zoltan-234/ROBI-esp32/docs/ROBI_Beuzemelesi_utmutato_szoftver.pdf

R.O.B.I.

## Radar · Óra · Barát · Időjárás

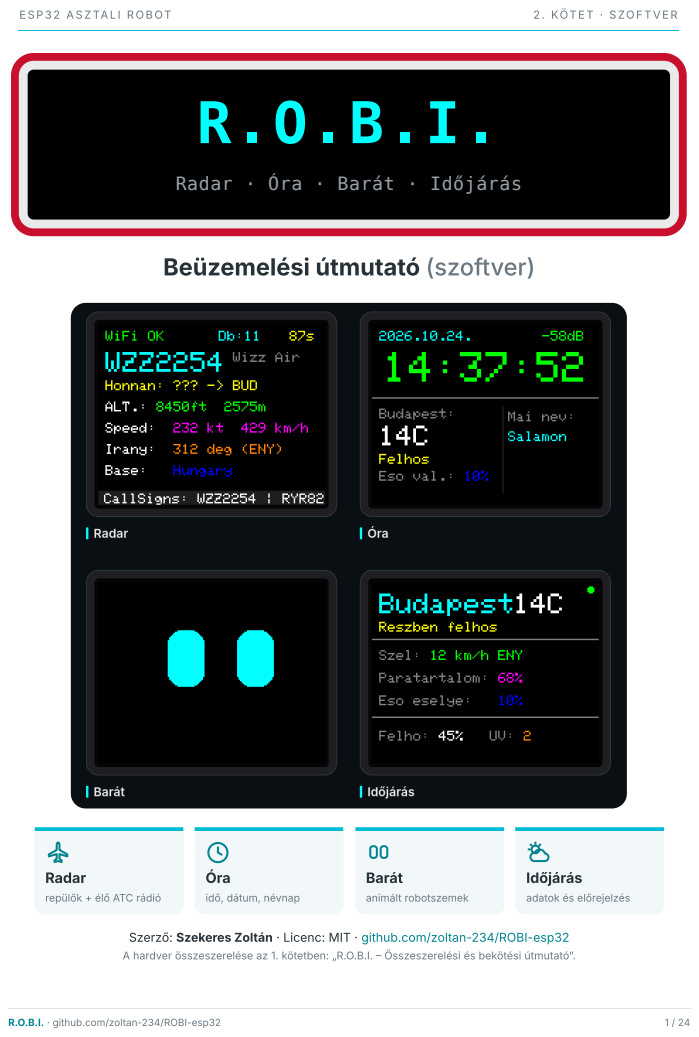
[picture p22: page 1]
ESP32 ASZTALI ROBOT; 2. KÖTET · SZOFTVER; Óra; Barát; animált robotszemek; A hardver összeszerelése az 1. kötetben: „R.O.B.I. –; Összeszerelési és bekötési útmutató”.; R.O.B.I. · github.com/zoltan-234/ROBI-esp32

Beüzemelési útmutató (szoftver)

Radar
repülők + élő ATC rádió

Időjárás
adatok és előrejelzés

idő, dátum, névnap

Szerző: Szekeres Zoltán · Licenc: MIT · github.com/zoltan-234/ROBI-esp32

R.O.B.I. · Beüzemelési útmutató (szoftver)

Kattints egy fejezetcímre, és a PDF odaugrik.

1 | Hogyan működik ROBI? | 3
2 | Letöltések – mit, honnan | 4
3 | Arduino IDE beállítása | 5
3.4 | Könyvtárak – pontos verziók | 6
4 | A projekt fájljai – mi hol van | 7
4.1 | secrets.h – kötelező | 7
4.2 | config.h – fő beállítások | 8
4.3 | ATC rádiócsatornák cseréje vagy bővítése | 9
4.4 | A repülőradar figyelt területe | 10
4.5 | Az időjárás helyszínének módosítása | 11
4.6 | Haladó beállítások | 12
5 | Gombok és módok – programonként | 13
5.1 | Repülőradar | 14
5.2 | Óra | 15
5.3 | Időjárás | 16
5.4 | Barát (MiniFace) | 17
5.4 | ROBI napirendje, éhség | 18
5.4 | ROBI arcai | 19
5.5 | „Nincs WiFi” képernyő | 20
6 | Alaplap-beállítások (Tools menü) | 21
7 | Feltöltés és első indítás | 22
8 | Gyakori hibák | 23
9 | Hasznos tudnivalók | 24

# Tartalom

R.O.B.I.

# 1 Hogyan működik ROBI?

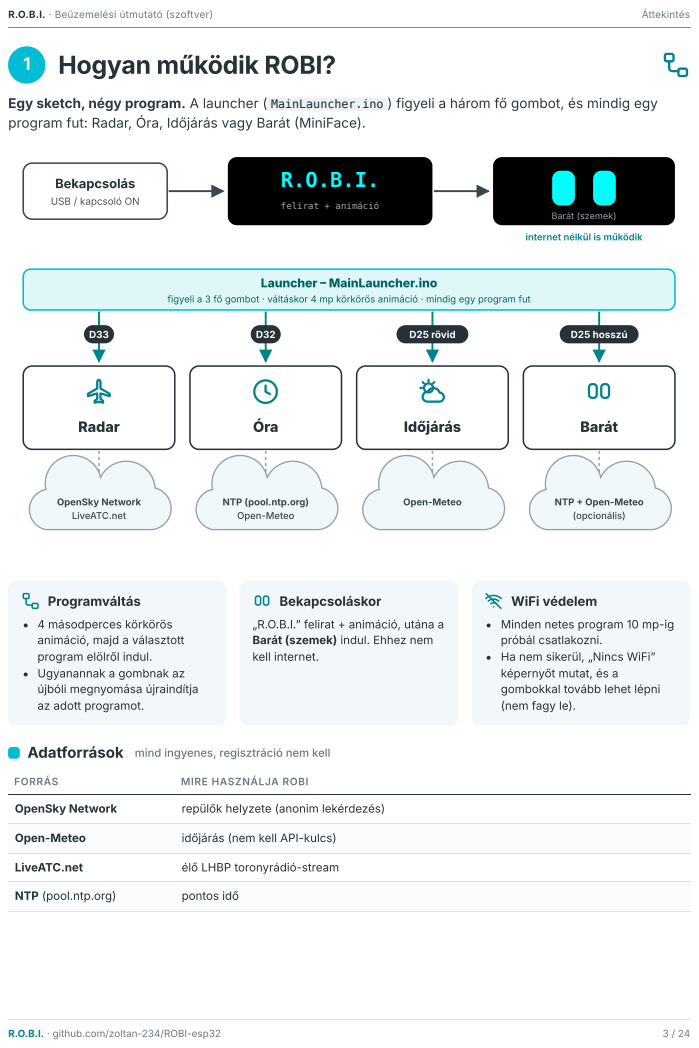
[picture p23: page 3]
R.O.B.I. · Beüzemelési útmutató (szoftver); Áttekintés; felirat + animáció; Barát (szemek); Launcher –; MainLauncher.ino; Radar; OpenSky Network LiveATC.net; Óra; D25 rövid; Időjárás; Open-Meteo; D25 hosszú; Barát; FORRÁS; MIRE HASZNÁLJA ROBI; OpenSky Network; repülők helyzete (anonim lekérdezés); időjárás (nem kell API-kulcs); LiveATC.net; élő LHBP toronyrádió-stream; NTP (pool.ntp.org); pontos idő

Egy sketch, négy program. A launcher ( MainLauncher.ino ) figyeli a három fő gombot, és mindig egy
program fut: Radar, Óra, Időjárás vagy Barát (MiniFace).

Bekapcsolás
USB / kapcsoló ON

internet nélkül is működik

figyeli a 3 fő gombot · váltáskor 4 mp körkörös animáció · mindig egy program fut

NTP (pool.ntp.org)
Open-Meteo

NTP + Open-Meteo
(opcionális)

Programváltás
4 másodperces körkörös
animáció, majd a választott
program elölről indul.
Ugyanannak a gombnak az
újbóli megnyomása újraindítja
az adott programot.

Bekapcsoláskor
„R.O.B.I.” felirat + animáció, utána a
Barát (szemek) indul. Ehhez nem
kell internet.

WiFi védelem
Minden netes program 10 mp-ig
próbál csatlakozni.
Ha nem sikerül, „Nincs WiFi”
képernyőt mutat, és a
gombokkal tovább lehet lépni
(nem fagy le).

Adatforrások mind ingyenes, regisztráció nem kell

R.O.B.I. · Beüzemelési útmutató (szoftver) | Előkészületek

Minden link kattintható. Nyomtatott példánynál a címet a böngészőbe gépelve éred el.

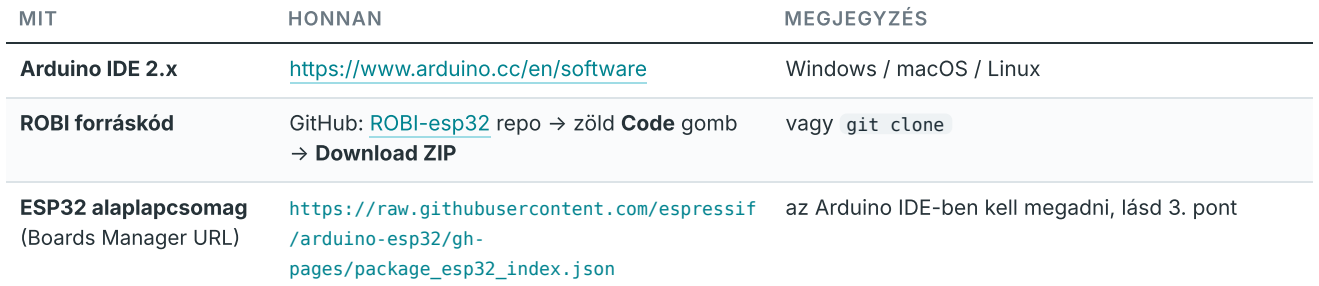
[picture p24: figure]
MIT; HONNAN; MEGJEGYZÉS; Arduino IDE 2.x; https://www.arduino.cc/en/software; Windows / macOS / Linux; → Download ZIP; vagy git clone; ESP32 alaplapcsomag (Boards Manager URL); https://raw.githubusercontent.com/espressif /arduino-esp32/gh- pages/package_esp32_index.json

ROBI forráskód | GitHub: ROBI-esp32 (https://github.com/zoltan-234/ROBI-esp32) repo → zöld Code gomb

az Arduino IDE-ben kell megadni, lásd 3. pont

ESP32-audioI2S 3.2.1 https://github.com/schreibfaul1/ESP32-audioI2S/releases/tag/3.2.1 (https://github.com/schreibfaul1/ESP32-audioI2S/releases/tag/3.2.1)

az oldal alján az Assets résznél: Source code (zip). Nincs a Library Managerben ebben a verzióban, ZIP-ből kell telepíteni

CP210x USB driver
(Silicon Labs)

https://www.silabs.com/software-and-tools/usb-to-uart-bridge-vcp-drivers?tab=downloads (https://www.silabs.com/software-and-tools/usb-to-uart-bridge-vcp-drivers?tab=downloads) a Downloads fülön a Windows-os „CP210x Universal Windows Driver”. Akkor kell, ha az ESP32 lapon CP2102 chip van (a legtöbb NodeMCU-32S / DevKit ilyen)

LiveATC – LHBP
csatornák

https://www.liveatc.net/search/?icao=LHBP az ATC rádió stream-linkjeihez, lásd 4.3

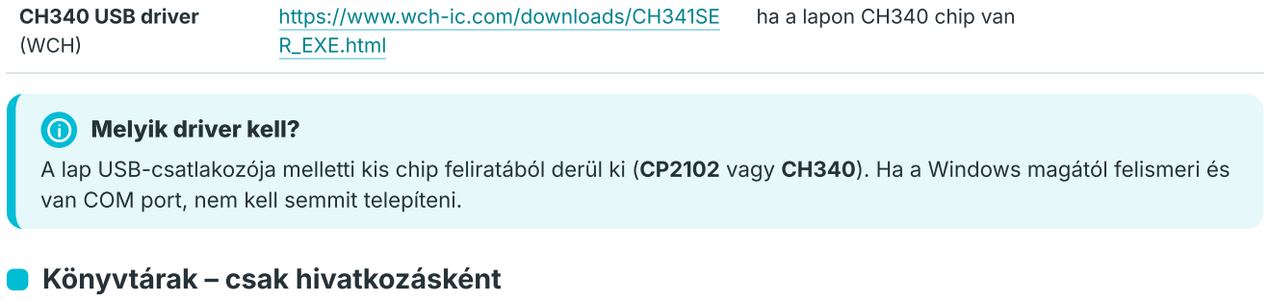
[picture p25: figure]
CH340 USB driver; (WCH); https://www.wch-ic.com/downloads/CH341SE R_EXE.html; ha a lapon CH340 chip van; Melyik driver kell?; Könyvtárak – csak hivatkozásként

A lap USB-csatlakozója melletti kis chip feliratából derül ki (CP2102 vagy CH340). Ha a Windows magától felismeri és van COM port, nem kell semmit telepíteni.

Ezeket az Arduino IDE Library Managerében kell telepíteni (nem kell letölteni). Hivatkozásként a GitHub oldaluk:

KÖNYVTÁR | OLDAL
Adafruit GFX Library | https://github.com/adafruit/Adafruit-GFX-Library
Adafruit ST7735 and ST7789 Library | https://github.com/adafruit/Adafruit-ST7735-Library
Adafruit BusIO | https://github.com/adafruit/Adafruit_BusIO
ArduinoJson | https://arduinojson.org
2 | Letöltések – mit, honnan

1 | Arduino IDE telepítése
2 | Boards Manager URL

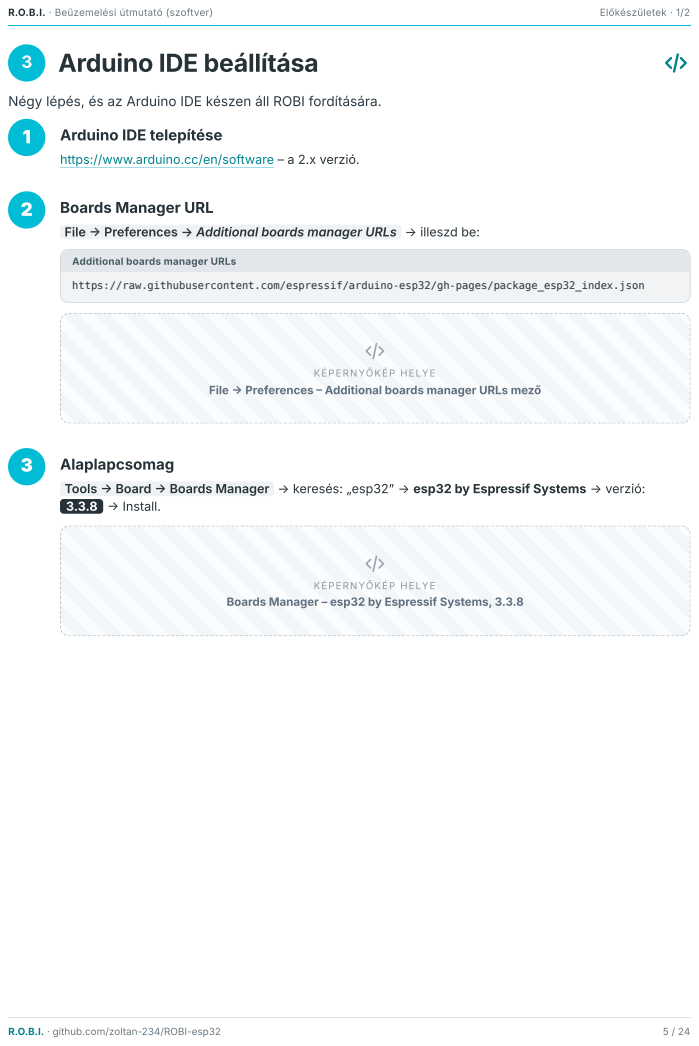
[picture p26: page 5]
R.O.B.I. · Beüzemelési útmutató (szoftver); Előkészületek · 1/2; KÉPERNYŐKÉP HELYE; File → Preferences –; Additional boards manager URLs mező; Alaplapcsomag; Arduino IDE beállítása

Négy lépés, és az Arduino IDE készen áll ROBI fordítására.

https://www.arduino.cc/en/software – a 2.x verzió.

File → Preferences → Additional boards manager URLs → illeszd be:

Additional boards manager URLs

https://raw.githubusercontent.com/espressif/arduino-esp32/gh-pages/package_esp32_index.json

Tools → Board → Boards Manager → keresés: „esp32” → esp32 by Espressif Systems → verzió:
3.3.8 → Install.

Boards Manager – esp32 by Espressif Systems, 3.3.8

R.O.B.I. · Beüzemelési útmutató (szoftver) | Előkészületek · 2/2
4 | Könyvtárak – pontos verziók
KÖNYVTÁR | SZERZŐ | VERZIÓ | TELEPÍTÉS
Adafruit GFX Library | Adafruit | 1.13.0 | Library Manager
Adafruit ST7735 and ST7789 Library | Adafruit | 1.12.0 | Library Manager
| | | Library Manager (a GFX telepítésekor felajánlja:

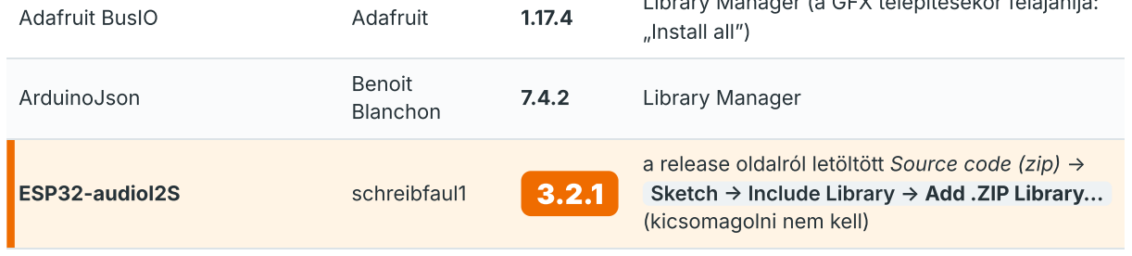
[picture p27: figure]
Adafruit BusIO; Adafruit; „Install all”); ArduinoJson; Benoit Blanchon; Library Manager; ESP32-audioI2S; schreibfaul1; (kicsomagolni nem kell)

a release oldalról letöltött Source code (zip) → Sketch → Include Library → Add .ZIP Library…

## Az ESP32-audioI2S-ből pontosan a 3.2.1 kell – ne a legújabbat telepítsd!

A kód a 3.2.1-hez igazodik, az újabbak API-ja eltér. Ez a verzió nincs a Library Managerben: a release

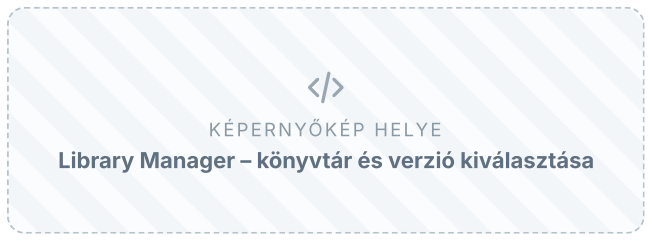
[picture p28: figure]
KÉPERNYŐKÉP HELYE

Library Manager – könyvtár és verzió kiválasztása

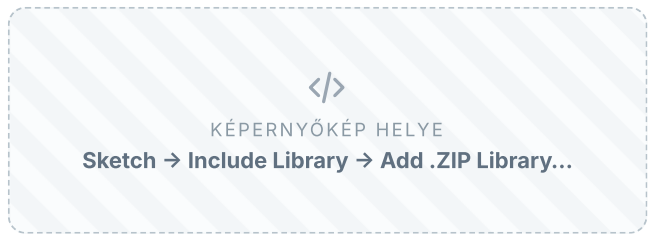
[picture p29: figure]
KÉPERNYŐKÉP HELYE

Sketch → Include Library → Add .ZIP Library…

A WiFi, a HTTPClient, a WiFiClientSecure és az SPI az ESP32 csomag része, ezeket nem kell külön telepíteni. Ezekkel a verziókkal a kód ellenőrzötten, hiba nélkül lefordul (flash 51%, RAM 21%).

# Arduino IDE beállítása – könyvtárak

R.O.B.I. · Beüzemelési útmutató (szoftver) | Beállítások

ROBI-esp32/

MainLauncher/ | ← ezt a mappát nyisd meg (MainLauncher.ino)
MainLauncher.ino | launcher: gombok, programváltás, indulóképernyő
secrets.example.h | MINTA a személyes adatokhoz → másold secrets.h néven
secrets.h | (te hozod létre) WiFi név + jelszó – nem kerül fel GitHubra | MÓDOSÍTOD
config.h | FŐ BEÁLLÍTÁSOK: város, koordináta, radar terület, ATC csatornák | MÓDOSÍTOD
WifiGuard.h | WiFi csatlakozás időkorláttal, „Nincs WiFi” képernyő
RadarApp.h | repülőradar + ATC rádió
OraApp.h | óra
IdojarasApp.h | időjárás
MiniFaceApp.h | Barát (robotszemek)
MiniFaceTypes.h | a szemek típusdefiníciói
SpinnerFrames.h | a körkörös animáció képkockái
docs/ | útmutatók, képek
hardware/ | bekötés

Ne nevezd át!
A MainLauncher mappa nevét ne nevezd át, mert az Arduino IDE megköveteli, hogy egyezzen az .ino nevével.

4.1 secrets.h – kötelező

secrets.h – ezt a két sort írd át

#define SECRET_WIFI_SSID | "IDE_A_WIFI_NEVE"

#define SECRET_WIFI_PASSWORD "IDE_A_WIFI_JELSZAVA"

Csak 2,4 GHz-es hálózat működik. Telefonos hotspot is jó (ha a telefonon választható, állítsd 2,4 GHz-re).
Az OpenSky sorokat hagyd üresen ( "" ). Az OpenSky 2026. március 18. óta nem fogadja el a felhasználónév + jelszó belépést. Üresen anonim módban kérdez, ami a 2 percenkénti frissítéshez elég.

Ha a secrets.h hiányzik, a fordító ezt írja ki:

#error "Hianyzik a secrets.h! Masold le a secrets.example.h fajlt secrets.h neven ugyanebbe a mappaba, e s ird bele a WiFi adataidat."

4 | A projekt fájljai – mi hol van
1 | Másold le a secrets.example.h -t ugyanabba a mappába secrets.h néven.
2 | Írd át ezt a két sort:

R.O.B.I. · Beüzemelési útmutató (szoftver) | Beállítások

A config.h a fő beállítások helye. Alapból Budapest és a Liszt Ferenc reptér környéke van beállítva.

BEÁLLÍTÁS | ALAPÉRTÉK | MIT JELENT
CFG_CITY_NAME | "Budapest" | a kijelzőn megjelenő városnév, max. 8 karakter, ékezet nélkül
CFG_WEATHER_LAT / CFG_WEATHER_LON | 47.50 / 19.04 | az időjárás helye. Google Maps → jobb klikk a helyre → a felső

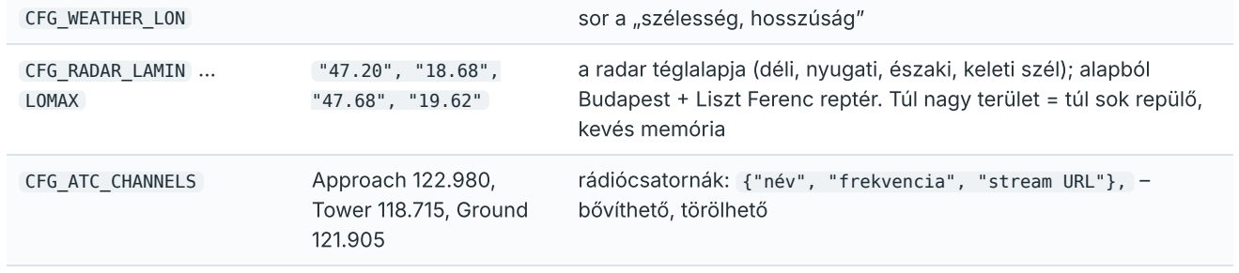
[picture p30: figure]
sor a „szélesség, hosszúság”; CFG_RADAR_LAMIN …; LOMAX; kevés memória; CFG_ATC_CHANNELS; Approach 122.980,; Tower 118.715, Ground 121.905; bővíthető, törölhető

| | a radar téglalapja (déli, nyugati, északi, keleti szél); alapból Budapest + Liszt Ferenc reptér. Túl nagy terület = túl sok repülő,

rádiócsatornák: {"név", "frekvencia", "stream URL"}, –

CFG_WIFI_TIMEOUT_MS | 10000 | ennyi ms-ig próbál csatlakozni egy program

## A három leggyakoribb módosítás

4.3 ATC rádiócsatornák

új csatorna a LiveATC Listen gombjával

4.4 A radar területe

téglalap a Google Maps-ből

4.5 Az időjárás helyszíne

város és koordináta

# 4.2 config.h – fő beállítások

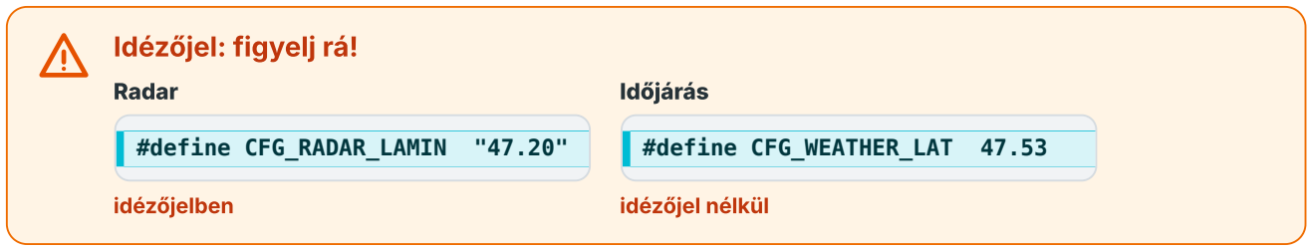
[picture p31: figure]
Idézőjel: figyelj rá!; Radar; #define CFG_RADAR_LAMIN "47.20"; idézőjelben; Időjárás; #define CFG_WEATHER_LAT 47.53; idézőjel nélkül

R.O.B.I. · Beüzemelési útmutató (szoftver) | Beállítások · LiveATC

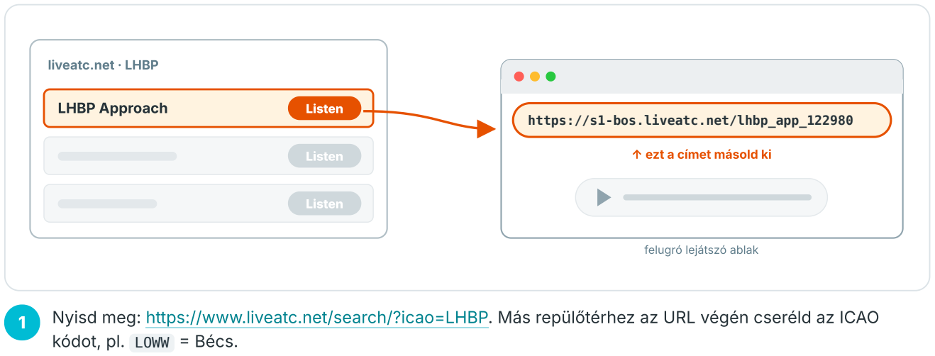
[picture p32: figure]
liveatc.net · LHBP; LHBP Approach; Listen; https://s1-bos.liveatc.net/lhbp_app_122980; ↑ ezt a címet másold ki; felugró lejátszó ablak; kódot, pl. LOWW =; Bécs.

Tipp: néma csatorna?

Ha egy csatorna néma, nyisd meg a linket böngészőben. Ha ott sem szól, a LiveATC éppen nem sugározza (éjjel gyakori).

Megjegyzés

A LiveATC streamek személyes hallgatásra valók.

# 4.3 ATC rádiócsatornák cseréje vagy bővítése

Nyisd meg: https://www.liveatc.net/search/?icao=LHBP. Más repülőtérhez az URL végén cseréld az ICAO

2 Keresd meg a kívánt csatornát (pl. „LHBP Approach”), és kattints a mellette lévő Listen gombra. Felugrik egy kis lejátszó ablak/oldal. Ennek a címsorában lévő link kell. Másold ki a böngésző címsorából. Így néz ki: https://s1-bos.liveatc.net/lhbp_app_122980

3

Nyisd meg a config.h -t, és a CFG_ATC_CHANNELS listába írd be egy új sorba:

1. a kijelzőn megjelenő név (rövid, ékezet nélkül) | 2. a frekvencia | 3. a kimásolt link
5 | Szabályok:
minden sor végén vessző és \ , kivéve az utolsó sort, ahol egyik sincs;
törölni is lehet sort;
a D27 gomb körbe lépked az összes csatornán.

6 Feltöltés után a Radar 2. oldalán (D26 rövid) ellenőrizd.

R.O.B.I. · Beüzemelési útmutató (szoftver) | Beállítások · Google Maps

A radar egy téglalap alakú területen belül keresi a repülőket. A téglalapot a déli-nyugati (bal alsó) és az északi-keleti (jobb felső) sarok koordinátája adja meg.

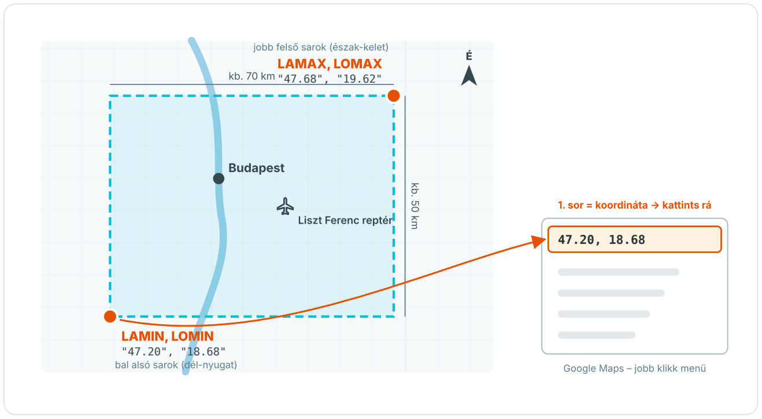
[picture p33: figure]
Budapest; Liszt Ferenc reptér; LAMIN, LOMIN "47.20", "18.68"; LAMAX, LOMAX "47.68", "19.62"; bal alsó sarok (dél-nyugat); jobb felső sarok (észak-kelet); Google Maps – jobb klikk menü; 1. sor = koordináta → kattints rá
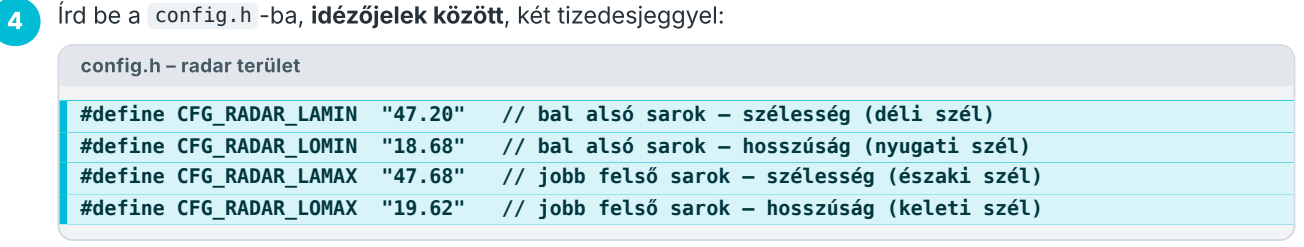
[picture p34: figure]
config.h – radar terület
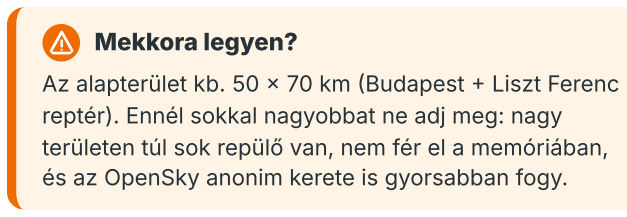
[picture p35: figure]
Mekkora legyen?

Az alapterület kb. 50 × 70 km (Budapest + Liszt Ferenc reptér). Ennél sokkal nagyobbat ne adj meg: nagy területen túl sok repülő van, nem fér el a memóriában, és az OpenSky anonim kerete is gyorsabban fogy.

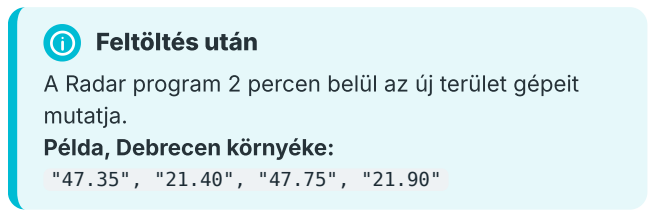
[picture p36: figure]
Feltöltés után; mutatja. Példa, Debrecen környéke: "47.35", "21.40", "47.75", "21.90"

A Radar program 2 percen belül az új terület gépeit

# 4.4 A repülőradar figyelt területe

Nyisd meg a Google Mapset, és keresd meg a területet, amit figyelni szeretnél. 1

Bal alsó sarok: jobb klikk a téglalap bal alsó sarkára → a menü legfelső sora a koordináta, pl. 47.20, 18.68 → kattints rá, ezzel kimásolod. Az első szám a szélesség (lat), a második a hosszúság (lon).

2

3 | Jobb felső sarok: ugyanígy, pl. 47.68, 19.62 . Írd be a config.h -ba, idézőjelek között, két tizedesjeggyel:
#define CFG_RADAR_LAMIN "47.20" | // bal alsó sarok – szélesség (déli szél)

#define CFG_RADAR_LOMIN "18.68" | // bal alsó sarok – hosszúság (nyugati szél)

#define CFG_RADAR_LAMAX "47.68" | // jobb felső sarok – szélesség (északi szél)

#define CFG_RADAR_LOMAX "19.62" | // jobb felső sarok – hosszúság (keleti szél)

5 | Szabály: a MIN mindig kisebb, mint a MAX.

R.O.B.I. · Beüzemelési útmutató (szoftver) | Beállítások · Google Maps

Ez a beállítás egyszerre három helyre hat: az Időjárás programra, az Óra időjárás-sorára és ROBI (Barát)

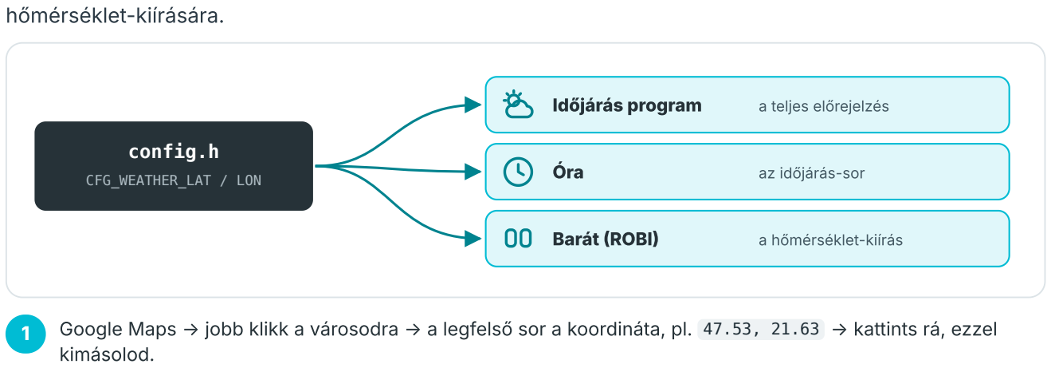
[picture p37: figure]
hőmérséklet-kiírására.; config.h; CFG_WEATHER_LAT / LON; Időjárás program; a teljes előrejelzés; Óra; az időjárás-sor; Barát (ROBI); a hőmérséklet-kiírás; kimásolod.
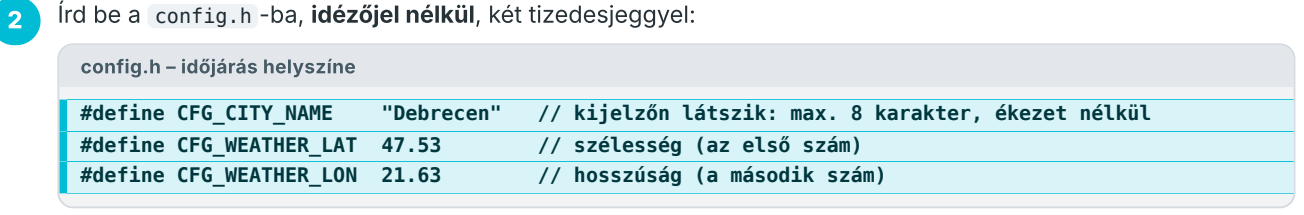
[picture p38: figure]
config.h – időjárás helyszíne; #define CFG_WEATHER_LAT 47.53; // szélesség (az első szám); #define CFG_WEATHER_LON 21.63; // hosszúság (a második szám)

A radar koordinátái idézőjelben vannak ( "47.20" ), az időjárásé idézőjel nélkül ( 47.53 ). Maradjon így,

# 4.5 Az időjárás helyszínének módosítása

Google Maps → jobb klikk a városodra → a legfelső sor a koordináta, pl. 47.53, 21.63 → kattints rá, ezzel

Írd be a config.h -ba, idézőjel nélkül, két tizedesjeggyel:

#define CFG_CITY_NAME | "Debrecen" | // kijelzőn látszik: max. 8 karakter, ékezet nélkül

A városnév ékezet nélkül legyen (a kijelző betűkészlete nem ismeri az ékezeteket), és legfeljebb 8 karakter, különben rácsúszik a hőmérsékletre. Hosszabb névnél rövidíts, pl. Székesfehérvár helyett "Szfvar" .

3

4 Feltöltés után az Időjárás program azonnal az új helyet mutatja.

# 4.6 Haladó beállítások

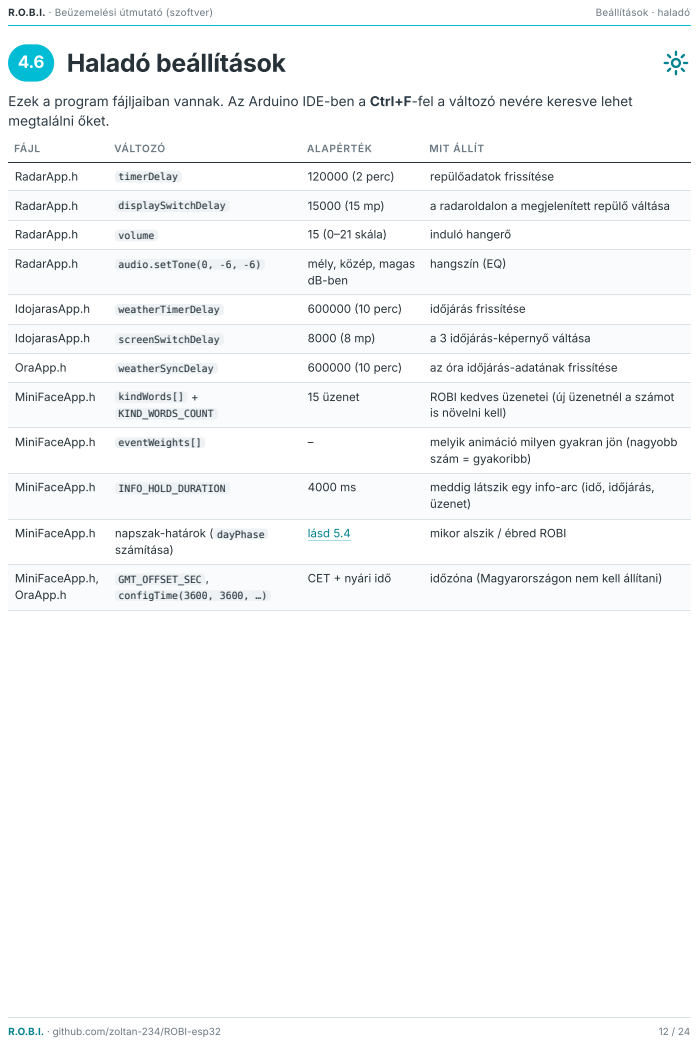
[picture p39: page 12]
R.O.B.I. · Beüzemelési útmutató (szoftver); Beállítások · haladó; FÁJL; VÁLTOZÓ; ALAPÉRTÉK; MIT ÁLLÍT; RadarApp.h; timerDelay; 120000 (2 perc); repülőadatok frissítése; displaySwitchDelay; a radaroldalon a megjelenített repülő váltása; volume; 15 (0–21 skála); induló hangerő; audio.setTone(0, -6, -6); mély, közép, magas; dB-ben; hangszín (EQ); IdojarasApp.h; weatherTimerDelay; 600000 (10 perc); időjárás frissítése; screenSwitchDelay; a 3 időjárás-képernyő váltása; OraApp.h; weatherSyncDelay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

Ezek a program fájljaiban vannak. Az Arduino IDE-ben a Ctrl+F-fel a változó nevére keresve lehet
megtalálni őket.

is növelni kell)

### Radar

### Óra

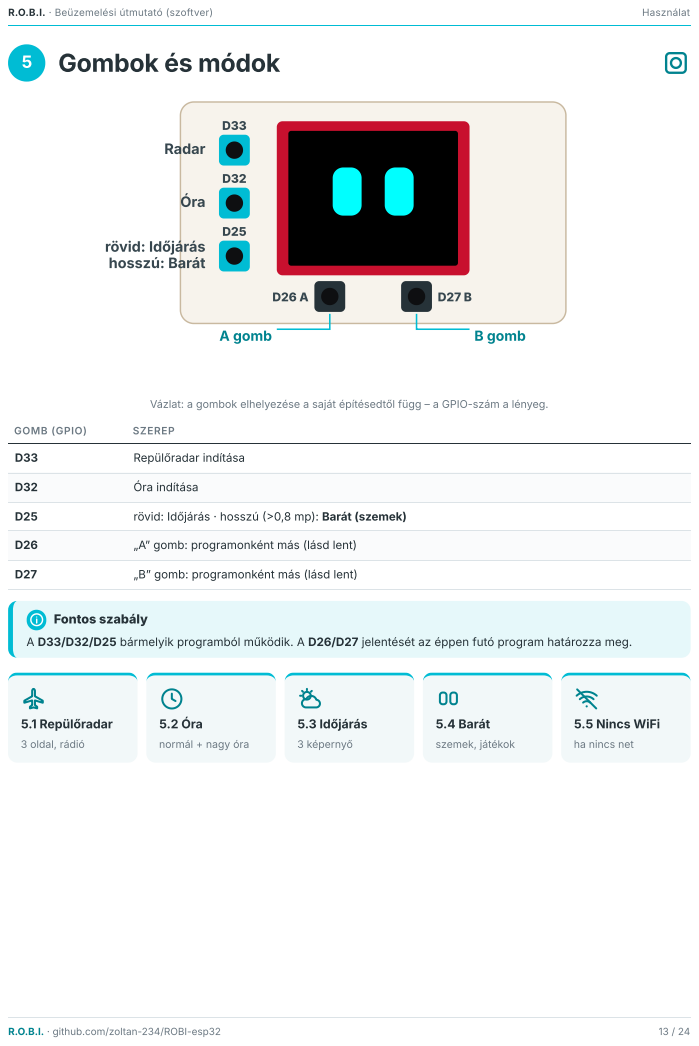
[picture p40: page 13]
R.O.B.I. · Beüzemelési útmutató (szoftver); Használat; rövid: Időjárás hosszú: Barát; A gomb; B gomb; GOMB (GPIO); SZEREP; Repülőradar indítása; Óra indítása; rövid: Időjárás · hosszú (>0,8 mp): Barát (szemek); „A” gomb: programonként más (lásd lent); „B” gomb: programonként más (lásd lent); 5.1 Repülőradar; 3 oldal, rádió; 5.3 Időjárás; 3 képernyő; 5.4 Barát; szemek, játékok; Gombok és módok

Vázlat: a gombok elhelyezése a saját építésedtől függ – a GPIO-szám a lényeg.

Fontos szabály
A D33/D32/D25 bármelyik programból működik. A D26/D27 jelentését az éppen futó program határozza meg.

5.2 Óra
normál + nagy óra

5.5 Nincs WiFi
ha nincs net

R.O.B.I. · Beüzemelési útmutató (szoftver) | Használat · D33

D33
Radar

D32
Óra

D25
rövid: Időjárás
hosszú: Barát

D26 A

rövid: következő oldal
hosszan: hangerő le

D27 B

rövid: köv. csatorna
hosszan: hangerő fel

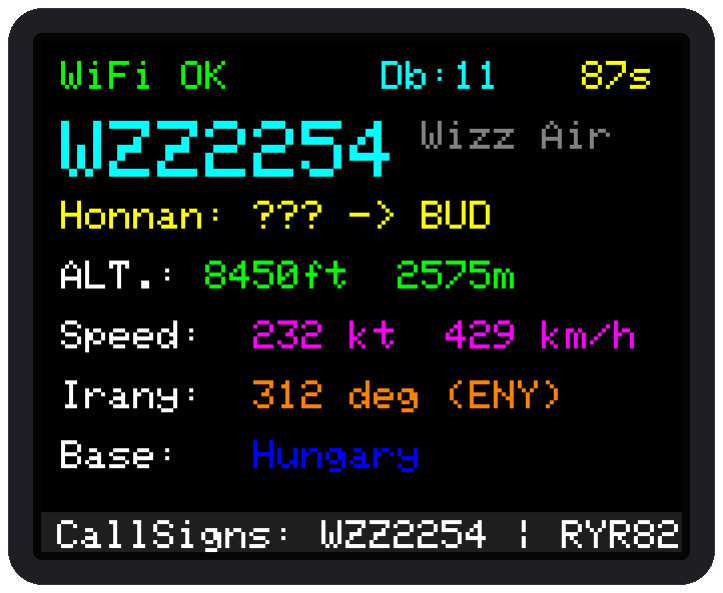
[picture p41: figure]

1. oldal – Radar: hívójel, légitársaság, magasság, sebesség, irány · alul futó hívójel-lista

## A 3 oldal

OLDAL | MIT MUTAT
1. Radar | a környék repülői (OpenSky), 15 mp-enként váltva a megjelenített gépet, visszaszámláló a
| következő frissítésig. A háttérben szól a rádió
2. Rádió | az aktuális ATC csatorna neve és frekvenciája, élő hang
3. Egyszerű radar | egyszerűsített repülőlista + a rádió a háttérben

## Gombok

GOMB | RÖVID NYOMÁS | HOSSZAN NYOMVA
D26 | következő oldal | hangerő le (ismétlődik, amíg nyomod)
D27 | következő ATC csatorna (a 2. és 3. oldalon) | hangerő fel (ismétlődik)

Hosszú nyomásnak a 0,5 mp-nél hosszabb számít.
Hangerő- és csatornaváltáskor rövid overlay jelenik meg a kijelzőn. A rádió csak a Radar programban szól. Programváltáskor leáll.

# 5.1 Repülőradar

## 5.2 Óra

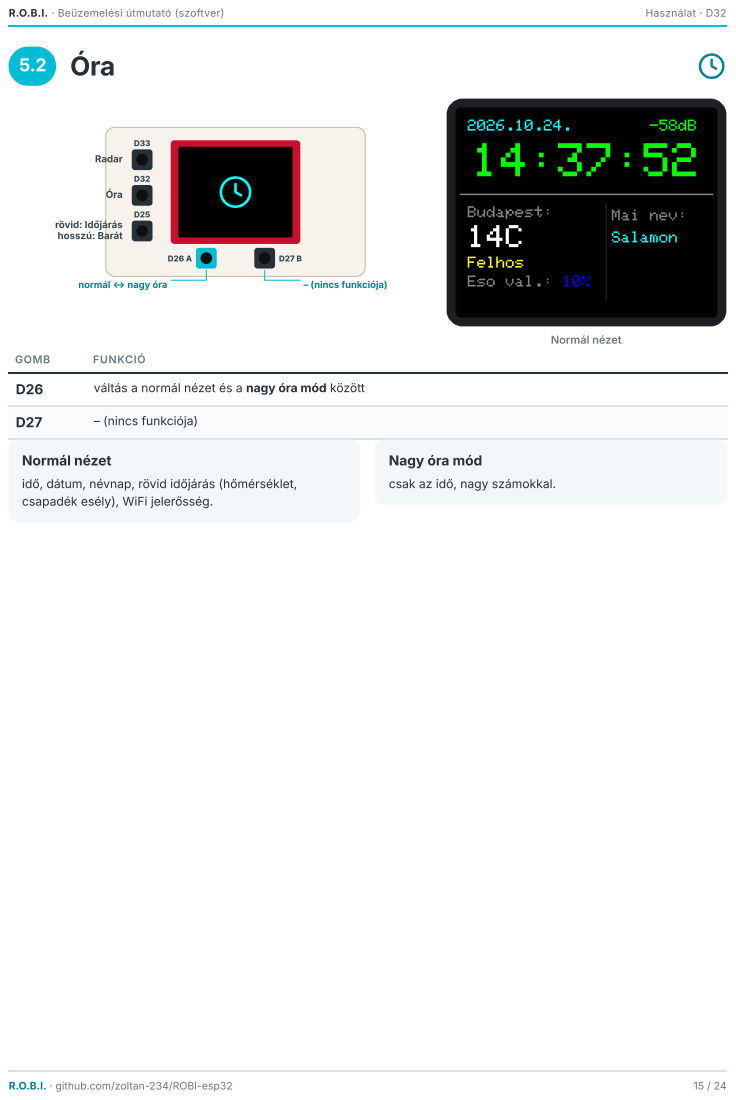
[picture p42: page 15]
R.O.B.I. · Beüzemelési útmutató (szoftver); Használat · D32; Radar; Óra; rövid: Időjárás hosszú: Barát; – (nincs funkciója); Normál nézet; GOMB; FUNKCIÓ; váltás a normál nézet és a nagy óra mód között

normál ↔ nagy óra

Normál nézet
idő, dátum, névnap, rövid időjárás (hőmérséklet,
csapadék esély), WiFi jelerősség.

Nagy óra mód
csak az idő, nagy számokkal.

# 5.3 Időjárás

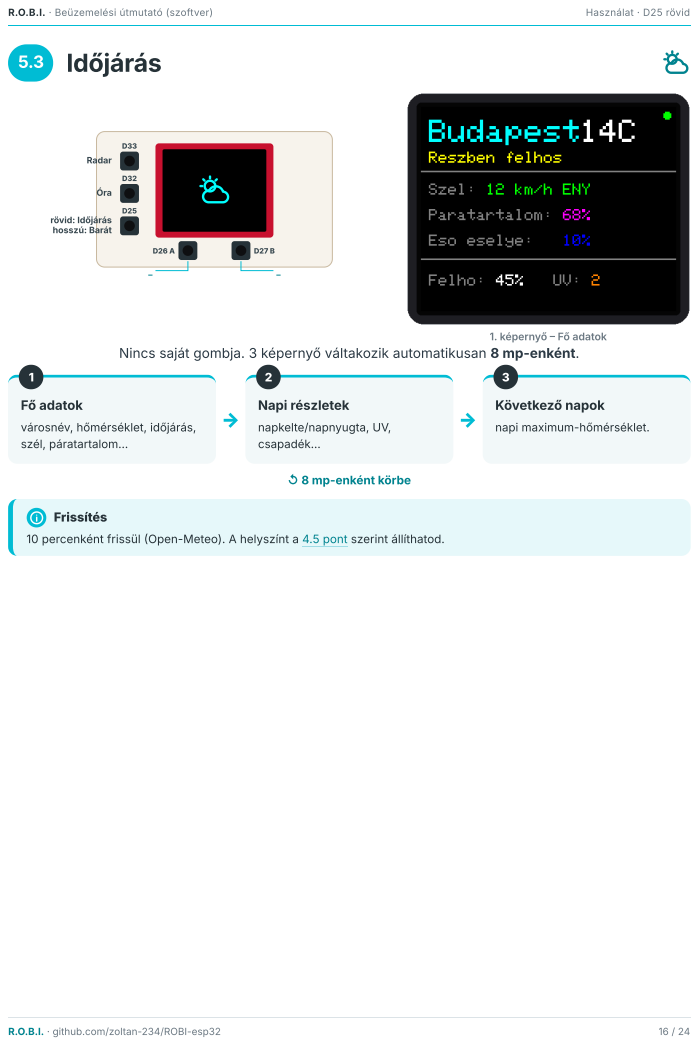
[picture p43: page 16]
R.O.B.I. · Beüzemelési útmutató (szoftver); Használat · D25 rövid; Radar; Óra; rövid: Időjárás hosszú: Barát; 1. képernyő –; Fő adatok

Nincs saját gombja. 3 képernyő váltakozik automatikusan 8 mp-enként.

Fő adatok
városnév, hőmérséklet, időjárás,
szél, páratartalom…

Napi részletek
napkelte/napnyugta, UV,
csapadék…

Következő napok
napi maximum-hőmérséklet.

↺ 8 mp-enként körbe

Frissítés
10 percenként frissül (Open-Meteo). A helyszínt a 4.5 pont szerint állíthatod.

R.O.B.I. · Beüzemelési útmutató (szoftver) | Használat · D25 hosszan · 1/3

D33
Radar

D32
Óra

D25
rövid: Időjárás
hosszú: Barát

D26 A

rövid: simogatás
hosszan: etetés / ébresztés

D27 B

rövid: játék menü
hosszan: info menü

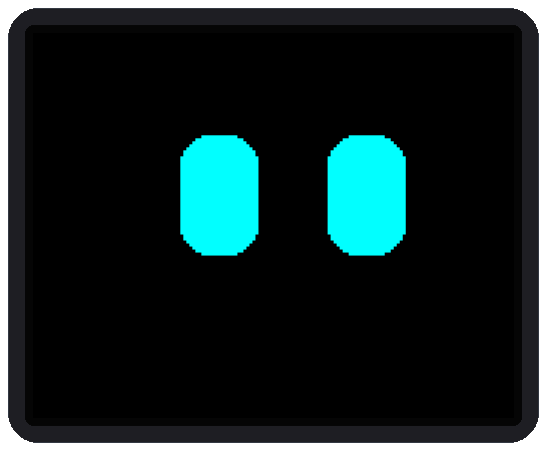
[picture p44: figure]

Alap állapot
GOMB | RÖVID NYOMÁS | HOSSZAN (>0,8 MP)
D26 | simogatás: ROBI örül, ugrál · játékban: választás
megerősítése / „Fej”

etetés / töltés, ha éhes (kör szem) · éjjel: felébresztés

D27 játék menü: ismételt nyomással lapoz a játékok között · játékban: „Írás”

info menü, sorban: pontos idő → kedves üzenet → kinti hőmérséklet

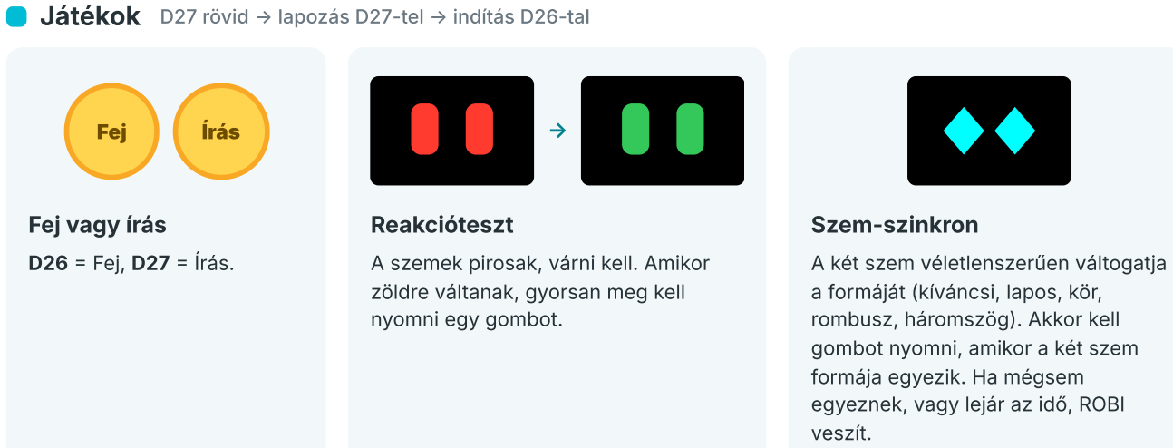
[picture p45: figure]
Fej; Írás; Fej vagy írás; Fej, D27 =; Írás.; Reakcióteszt; A szemek pirosak, várni kell. Amikor zöldre váltanak, gyorsan meg kell nyomni egy gombot.; Szem-szinkron; A két szem véletlenszerűen váltogatja a formáját (kíváncsi, lapos, kör, rombusz, háromszög). Akkor kell gombot nyomni, amikor a két szem formája egyezik. Ha mégsem egyeznek, vagy lejár az idő, ROBI veszít.

Játékok D27 rövid → lapozás D27-tel → indítás D26-tal

# 5.4 Barát (MiniFace)

R.O.B.I. · Beüzemelési útmutató (szoftver) | Használat · D25 hosszan · 2/3

ROBI napirendje ha van internet a pontos időhöz

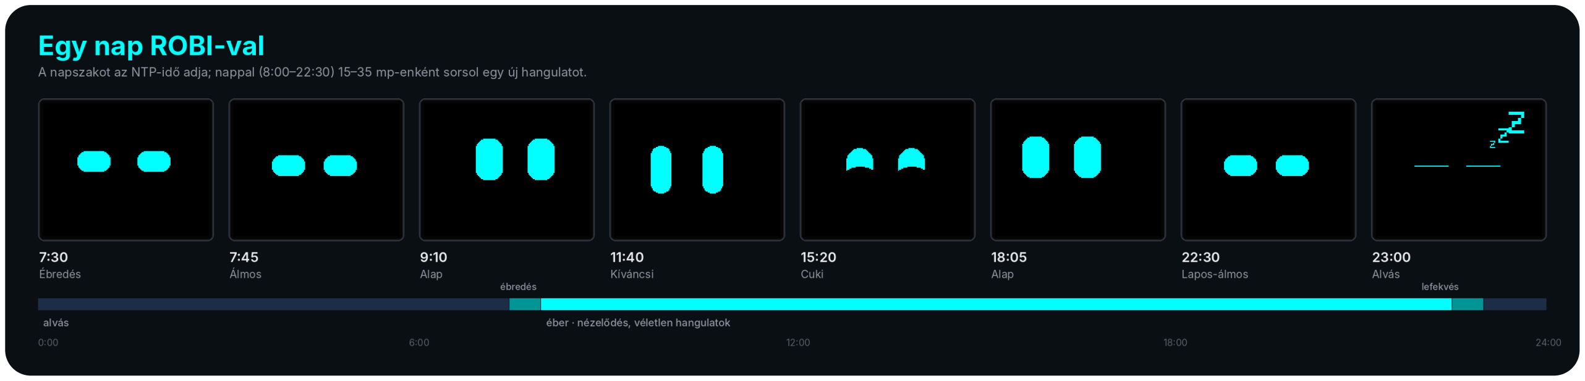
[picture p46: figure]

IDŐSZAK | ÁLLAPOT
23:00 – | 7:30 | alszik (Zzz). Hosszú gombnyomással felébreszthető egy időre
7:30 – | 8:00 | ébredezik
8:00 – | 22:30 | aktív: nézelődik, magától animációkat játszik, néha kiírja az időt, az időjárást vagy egy kedves
üzenetet
22:30 – | 23:00 | álmosodik (lapos szemek)

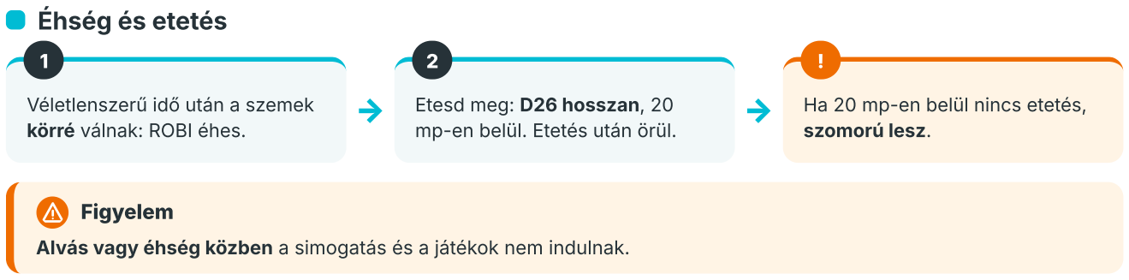
[picture p47: figure]
Éhség és etetés; Figyelem; Véletlenszerű idő után a szemek körré válnak: ROBI éhes.; Etesd meg: D26 hosszan, 20 mp-en belül. Etetés után örül.; Ha 20 mp-en belül nincs etetés, szomorú lesz.

Alvás vagy éhség közben a simogatás és a játékok nem indulnak.

# Barát – napirend és éhség

# ROBI arcai

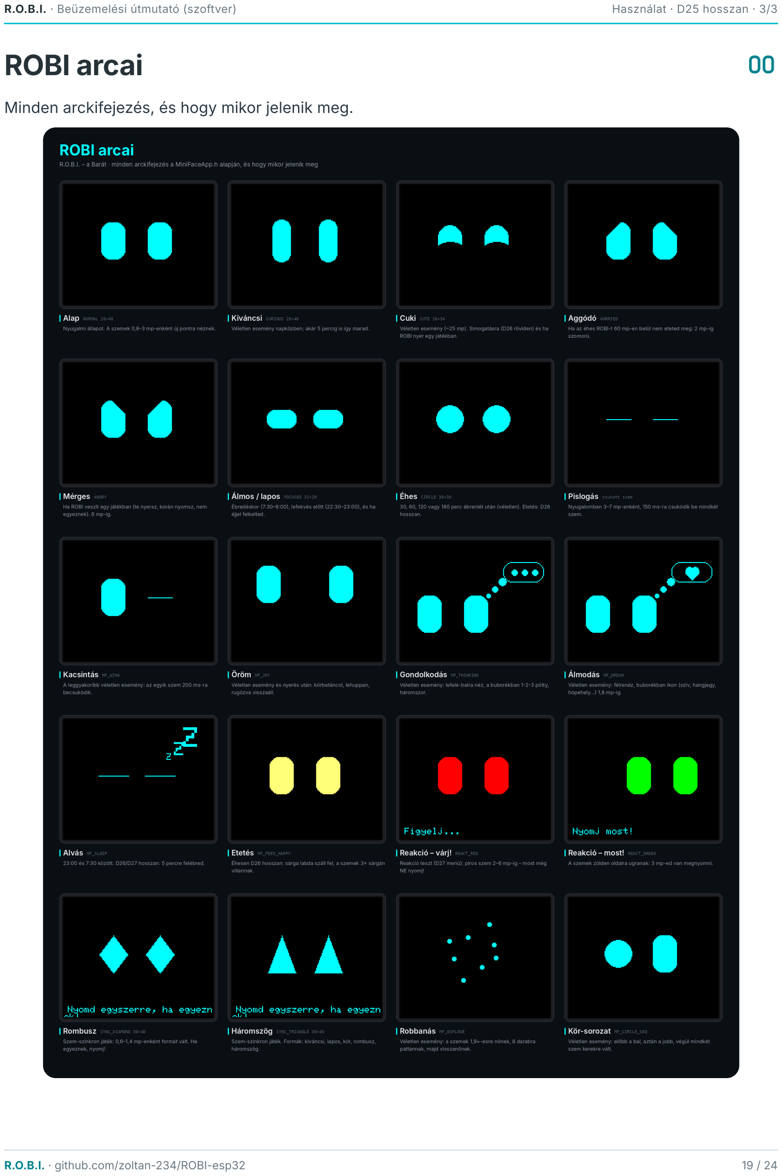
[picture p48: page 19]

R.O.B.I. · Beüzemelési útmutató (szoftver) | Használat · D25 hosszan · 3/3

Minden arckifejezés, és hogy mikor jelenik meg.

### újra: Radar

### újra: Óra

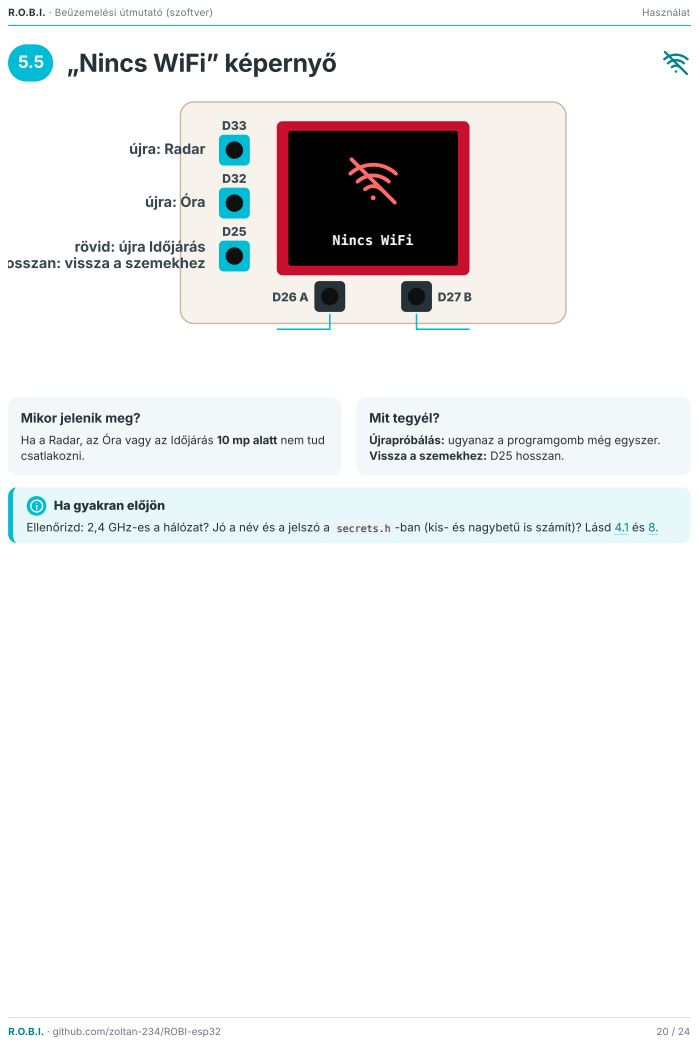
[picture p49: page 20]
R.O.B.I. · Beüzemelési útmutató (szoftver); Használat; Nincs WiFi

„Nincs WiFi” képernyő

rövid: újra Időjárás

osszan: vissza a szemekhez

Mikor jelenik meg?
Ha a Radar, az Óra vagy az Időjárás 10 mp alatt nem tud
csatlakozni.

Mit tegyél?
Újrapróbálás: ugyanaz a programgomb még egyszer.
Vissza a szemekhez: D25 hosszan.

Ha gyakran előjön
Ellenőrizd: 2,4 GHz-es a hálózat? Jó a név és a jelszó a secrets.h -ban (kis- és nagybetű is számít)? Lásd 4.1 és 8.

# 6 Alaplap-beállítások (Tools menü)

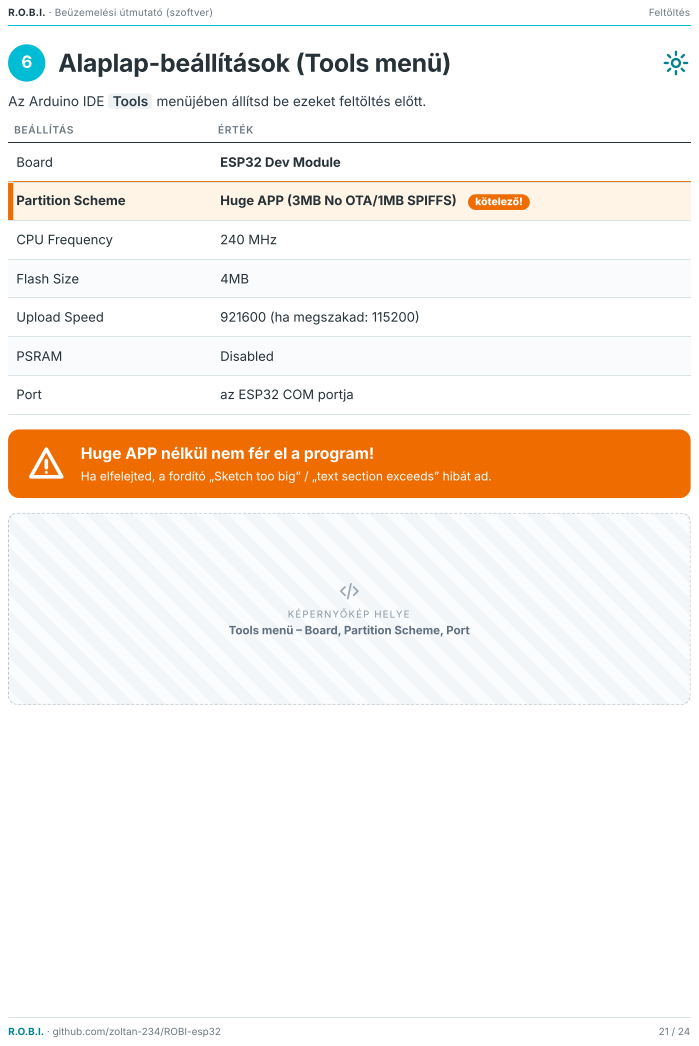
[picture p50: page 21]
R.O.B.I. · Beüzemelési útmutató (szoftver); Feltöltés; BEÁLLÍTÁS; ÉRTÉK; Board; ESP32 Dev Module; Partition Scheme; Huge APP (3MB No OTA/1MB SPIFFS); kötelező!; CPU Frequency; 240 MHz; Flash Size; Upload Speed; 921600 (ha megszakad: 115200); PSRAM; Disabled; Port; az ESP32 COM portja; KÉPERNYŐKÉP HELYE; Tools menü –; Board, Partition Scheme, Port

Az Arduino IDE Tools menüjében állítsd be ezeket feltöltés előtt.

Huge APP nélkül nem fér el a program!

Ha elfelejted, a fordító „Sketch too big” / „text section exceeds” hibát ad.

R.O.B.I. · Beüzemelési útmutató (szoftver) | Feltöltés

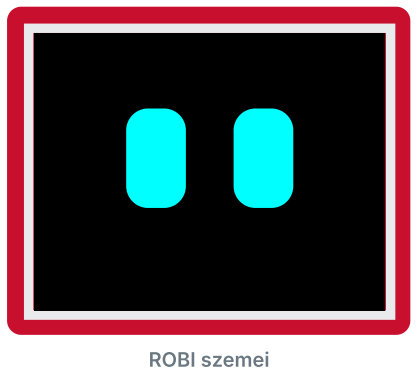
[picture p51: figure]
ROBI szemei

→

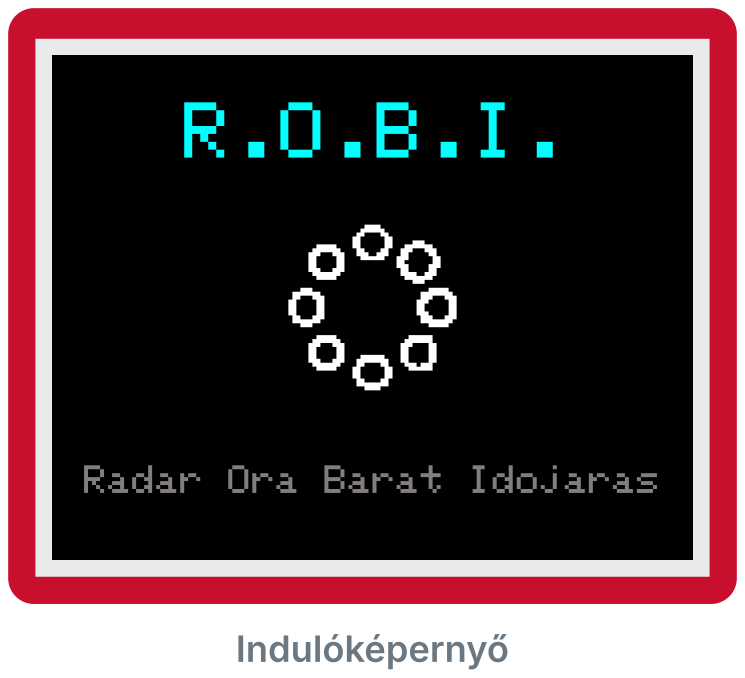
[picture p52: figure]
Indulóképernyő

## A „Reset ok” sor

A Serial Monitor „Reset ok” sora megmondja, miért indult újra az eszköz:

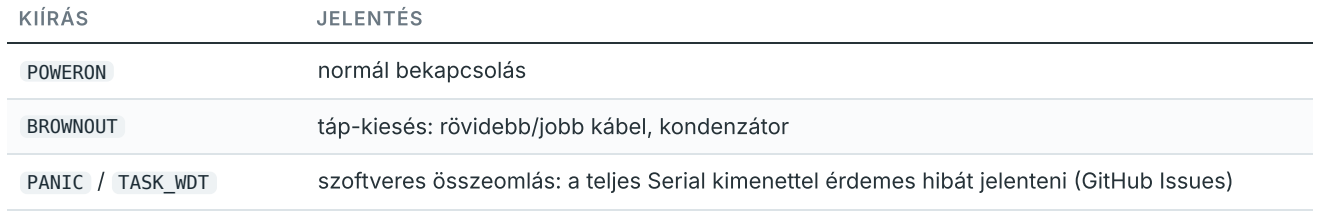
[picture p53: figure]
KIÍRÁS; JELENTÉS; POWERON; normál bekapcsolás; BROWNOUT; táp-kiesés: rövidebb/jobb kábel, kondenzátor

PANIC / TASK_WDT | szoftveres összeomlás: a teljes Serial kimenettel érdemes hibát jelenteni (GitHub Issues)
7 | Feltöltés és első indítás

Csatlakoztasd az ESP32-t USB adatkábellel. A töltőkábel nem jó, azon nincs adatvonal. 1

2 Válaszd ki a portot, majd nyomd meg az Upload gombot. Ha a feltöltés „Connecting…”⁻nél megáll, tartsd nyomva a lapon a BOOT gombot, amíg el nem indul. Serial Monitor, 115200 baud. Ezt kell látni:

=== R.O.B.I. - ESP32 Multi-Program Launcher ===

4 A kijelzőn: fent „R.O.B.I.”, középen a forgó animáció, alul „Radar Ora Barat Idojaras”, utána ROBI szemei.

R.O.B.I. · Beüzemelési útmutató (szoftver) | Hibaelhárítás
HIBA | TEENDŐ
„Hianyzik a secrets.h!” | 4.1 pont
„Sketch too big” / „text section exceeds” | Partition Scheme → Huge APP
Nincs COM port | driver (2. pont), adatkábel, másik USB port
Feltöltés megszakad | Upload Speed 115200, BOOT gomb, másik kábel, ne USB-hubon át
Fordítási hiba az Audio.h-ban | rossz ESP32-audioI2S verzió → pontosan a 3.2.1 kell

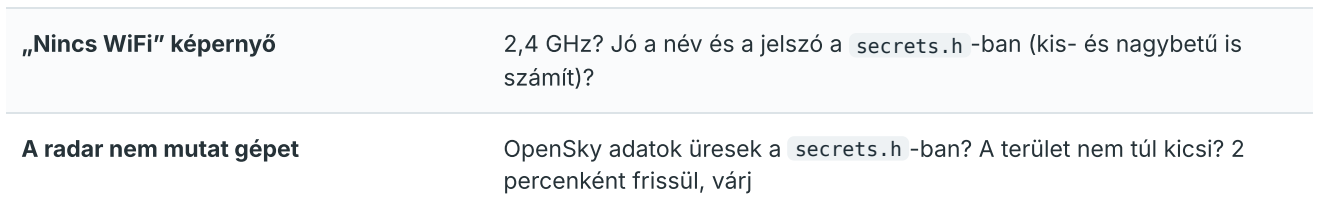
[picture p54: figure]
számít)?; percenként frissül, várj

„Nincs WiFi” képernyő | 2,4 GHz? Jó a név és a jelszó a secrets.h -ban (kis- és nagybetű is
A radar nem mutat gépet | OpenSky adatok üresek a secrets.h -ban? A terület nem túl kicsi? 2
Néma rádió | bekötés (összeszerelési útmutató), hangerő (D27 hosszan), a stream URL él-e (böngészőben)
Rossz város / hőmérséklet | config.h koordináták
8 | Gyakori hibák

# 9 Hasznos tudnivalók

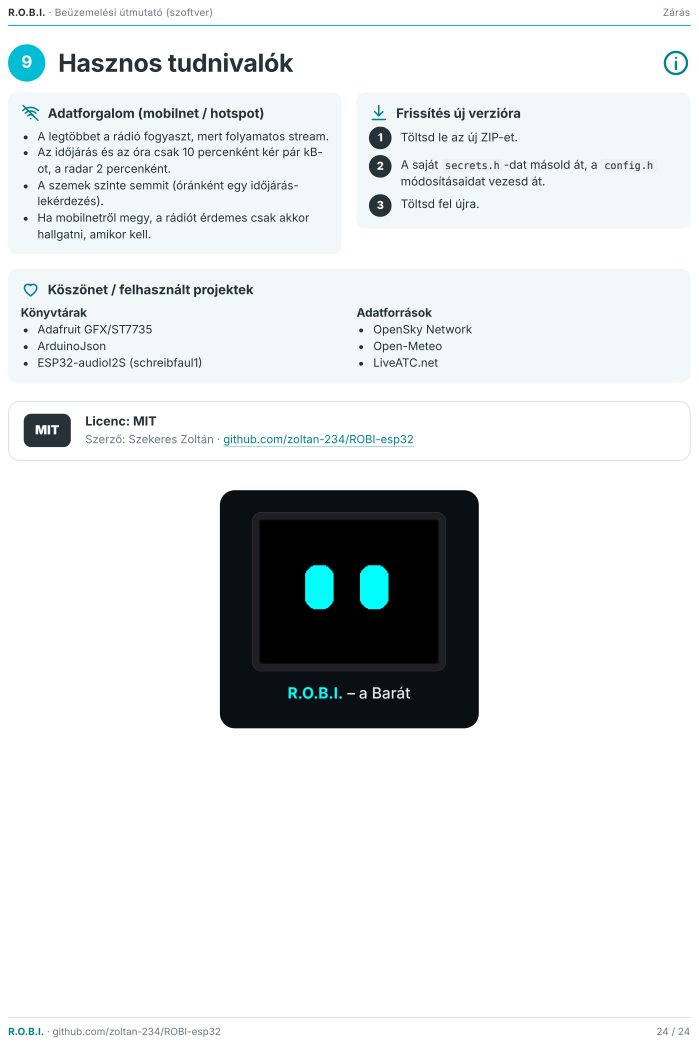
[picture p55: page 24]
R.O.B.I. · Beüzemelési útmutató (szoftver); Zárás; Köszönet / felhasznált projektek; Könyvtárak Adafruit GFX/ST7735 ArduinoJson ESP32-audioI2S (schreibfaul1); Adatforrások OpenSky Network Open-Meteo LiveATC.net; MIT; Töltsd le az új ZIP-et.; Töltsd fel újra.

Adatforgalom (mobilnet / hotspot)
A legtöbbet a rádió fogyaszt, mert folyamatos stream.
Az időjárás és az óra csak 10 percenként kér pár kB-
ot, a radar 2 percenként.
A szemek szinte semmit (óránként egy időjárás-
lekérdezés).
Ha mobilnetről megy, a rádiót érdemes csak akkor
hallgatni, amikor kell.

Frissítés új verzióra

A saját secrets.h -dat másold át, a config.h
módosításaidat vezesd át.

Licenc: MIT
Szerző: Szekeres Zoltán · github.com/zoltan-234/ROBI-esp32
