zoltan-234/ROBI-esp32/docs/fotok/README.md

# 📷 Fotók a kész R.O.B.I.-ról

| Fájl | Mi látszik rajta |
|---|---|
| `00-robi.jpg` | kivágott kép a főoldal tetejére |
| `01-elolrol.jpg` | felülről: ESP32, 3 programgomb, kijelző, 2 vezérlőgomb |
| `02-ferden.jpg` | a Barát szemei bekapcsolás után |
| `03-oldalrol.jpg` | oldalról: a panel alatt a MAX98357 erősítő és a főkapcsoló |
| `04-felulrol-ferden.jpg` | távtartókon állva, hátul alatta a hangszóró |

Új fotó hozzáadásához tedd ide a képet (JPG, kb. 1400 px, 1 MB alatt), és ha a főoldalon is látszania kell, vegyél fel neki egy sort a README galériájába.
