zoltan-234/ROBI-esp32/docs/images/robi-device.png

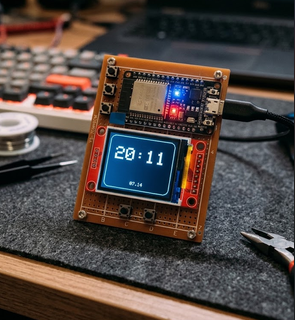
docs/images/robi-device.png
