zoltan-234/ROBI-esp32/docs/images/robi-hero.png

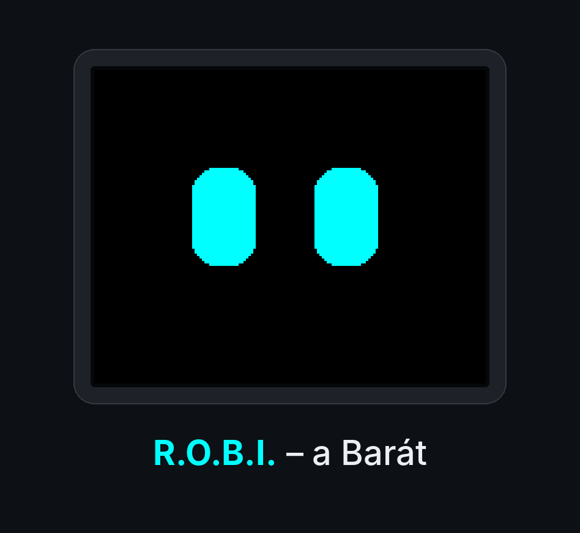
docs/images/robi-hero.png
