zoltan-234/ROBI-esp32/docs/images/screens/radar-overlay-volume-down.png

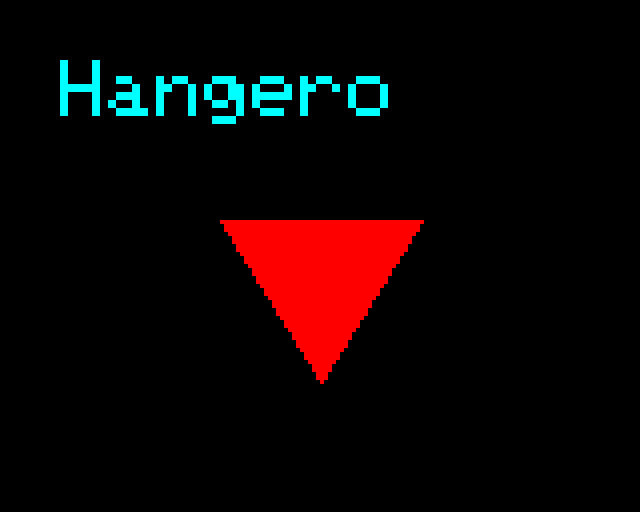
docs/images/screens/radar-overlay-volume-down.png
