zoltan-234/ROBI-esp32/docs/images/screens/radar-simple-empty.png

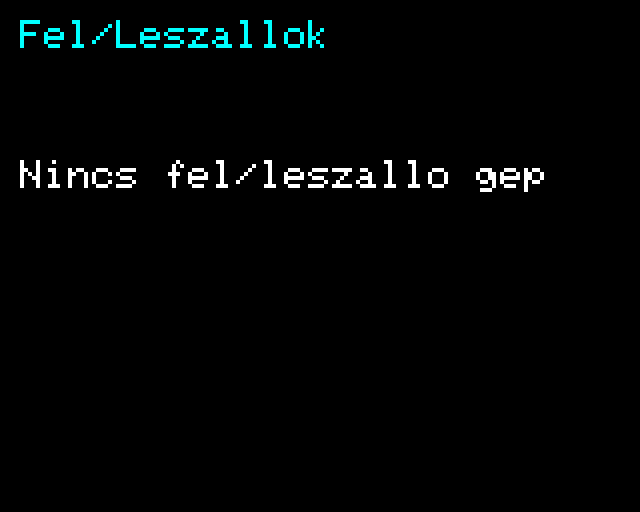
docs/images/screens/radar-simple-empty.png
