zoltan-234/ROBI-esp32/MainLauncher/SpinnerFrames.h

#ifndef SPINNER_FRAMES_H
#define SPINNER_FRAMES_H

// =========================================================
//  A korkoros.ino EREDETI animacioja, valtozatlanul.
//  48x48 px, 28 keret, 42 ms/keret.
// =========================================================

#define SPIN_W            48
#define SPIN_H            48
#define SPIN_FRAME_DELAY  42
#define SPIN_FRAME_COUNT  28

const byte PROGMEM spinFrames[SPIN_FRAME_COUNT][288] = {
  {0,0,0,0,0,0,0,0,0,0,0,0,0,0,0,0,0,0,0,0,3,192,0,0,0,0,7,224,0,0,0,0,12,48,0,0,0,0,24,24,0,0,0,0,24,24,56,0,0,62,24,24,254,0,0,127,12,49,199,0,0,227,142,113,131,0,0,193,135,227,129,128,0,193,128,3,1,128,0,193,128,3,131,128,0,227,128,1,131,0,0,127,0,1,231,0,0,62,0,0,254,0,0,0,0,0,56,0,0,0,0,0,0,0,3,128,0,0,3,224,15,224,0,0,15,240,12,112,0,0,14,56,24,48,0,0,28,24,24,48,0,0,24,24,24,48,0,0,24,24,24,48,0,0,28,24,12,112,0,0,14,56,15,224,0,0,15,240,3,128,0,0,3,224,0,0,0,0,0,0,0,0,0,0,0,0,0,62,0,0,126,0,0,127,0,0,254,0,0,227,128,1,195,0,0,193,128,1,131,0,0,193,128,1,131,0,0,193,135,225,131,0,0,227,143,241,131,0,0,127,12,48,238,0,0,62,24,24,126,0,0,0,24,24,0,0,0,0,24,24,0,0,0,0,12,48,0,0,0,0,15,240,0,0,0,0,3,192,0,0,0,0,0,0,0,0,0,0,0,0,0,0,0,0,0,0,0,0},
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
  {0,0,0,0,0,0,0,0,0,0,0,0,0,0,0,0,0,0,0,0,3,192,0,0,0,0,7,224,0,0,0,0,12,48,0,0,0,0,24,24,0,0,0,0,24,24,0,0,0,62,24,24,124,0,0,127,12,48,254,0,0,227,142,113,195,0,0,193,135,225,131,0,0,193,128,1,131,0,0,193,128,1,131,0,0,227,128,1,195,0,0,127,0,0,254,0,0,62,0,0,124,0,0,0,0,0,0,0,0,0,0,0,0,0,3,128,0,0,3,224,15,224,0,0,15,240,12,112,0,0,12,56,24,48,0,0,28,24,24,48,0,0,24,28,24,48,0,0,24,28,24,48,0,0,28,24,12,112,0,0,12,56,15,224,0,0,15,240,3,128,0,0,7,224,0,0,0,0,0,0,0,0,0,0,56,0,0,62,0,0,254,0,0,127,0,1,255,0,0,227,128,1,131,0,0,193,128,1,131,128,0,193,129,131,1,128,0,193,135,225,131,0,0,227,142,113,131,0,0,127,28,57,231,0,0,62,24,24,254,0,0,0,24,24,56,0,0,0,24,24,0,0,0,0,12,48,0,0,0,0,15,240,0,0,0,0,7,224,0,0,0,0,0,0,0,0,0,0,0,0,0,0,0,0,0,0,0,0}
};

#endif
